verdieranatole-hub/V-plotter-sur-table-a-dessin/README.md

# V-plotter-sur-table-a-dessin
projet de V-plotter réalisé dans le cadre de mon stage de troisième année de licence mécanique au pôle S.mart de l'université polytechnique des Hauts de France.
