verdieranatole-hub/V-plotter-sur-table-a-dessin/liste du materiel.md

# liste du matériel

|produit|quantité nécéssaire|marchand suggéré|prix|
|-|-|-|-|
|arduino uno|2|||
|CNC shield V3|1|||
|A4988 stepper motor driver|2|||
|moteur nema17(modèle prévu: 17HS4023)|2|||
|servomoteur SM2309S (modèle modifiable en fonction de ce dont vous disposez)|1|||
|alimentation S120-12|1|||
|poulie GT2 6mm|2|||
|courroie GT2 6mm|5m|||
|bague bronze ...|1|||
|tasseau (matériau quelconque)|en fonction de la largeur souhaitez de la machine||
|câble 3 fils souple|2,5m|||
|câble avec prise secteur|1 de la longueur que vous souhaitez|||
|ressort 30mm - 13mm - 11mm|1|||
||||estimé: 90€|
