verdieranatole-hub/V-plotter-sur-table-a-dessin/pièces/nacelles/V-plotter-nacelleCorps.step

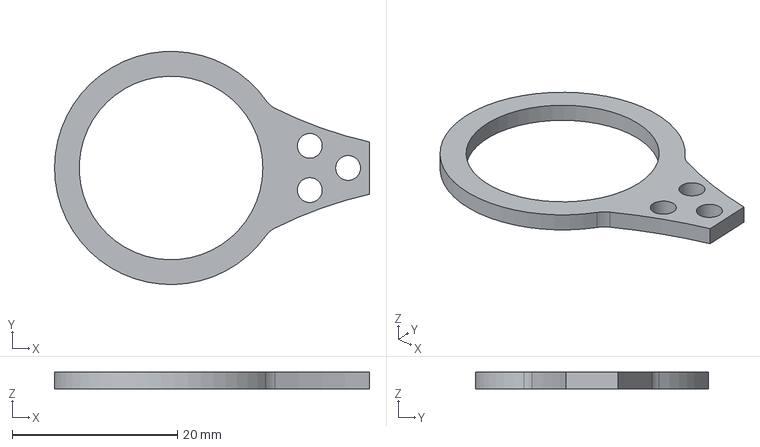
[picture p1: CAD file, 2026-07-15]
pièces/nacelles/V-plotter-nacelleCorps.step
38.1 x 28.2 x 2.00 mm
