verdieranatole-hub/V-plotter-sur-table-a-dessin/pièces/support_moteur.step

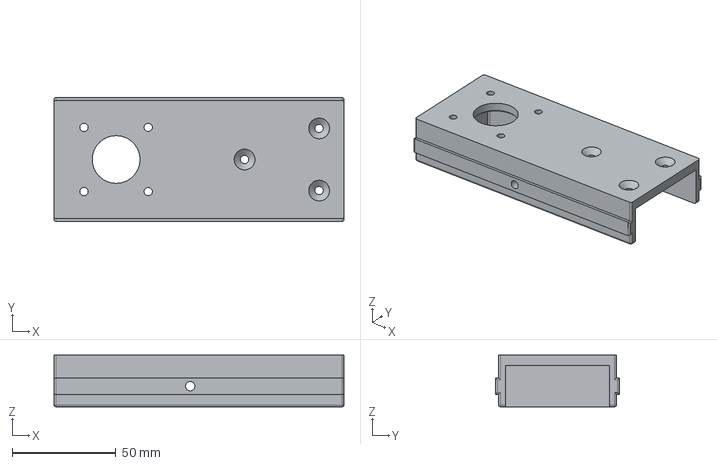
[picture p2: CAD file, 2026-07-13]
pièces/support_moteur.step
140.0 x 60.0 x 25.0 mm
