verdieranatole-hub/V-plotter-sur-table-a-dessin/pièces/nacelles/V-plotter-nacellepatin.step

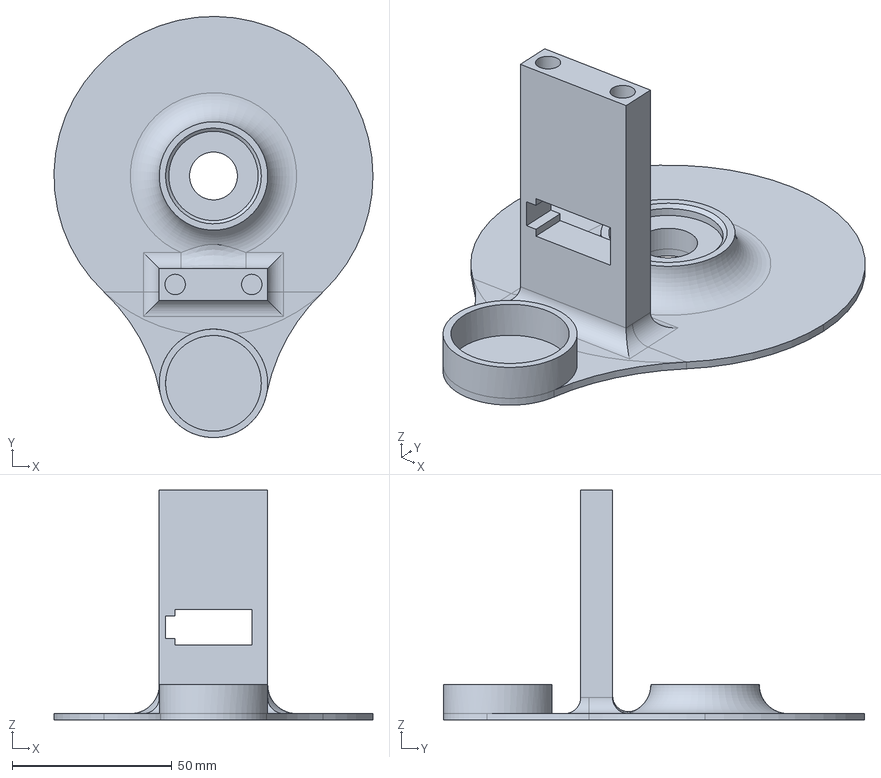
[picture p3: CAD file, 2026-07-15]
pièces/nacelles/V-plotter-nacellepatin.step
100.0 x 132.0 x 72.1 mm
