verdieranatole-hub/V-plotter-sur-table-a-dessin/pièces/V-plotter.FCStd

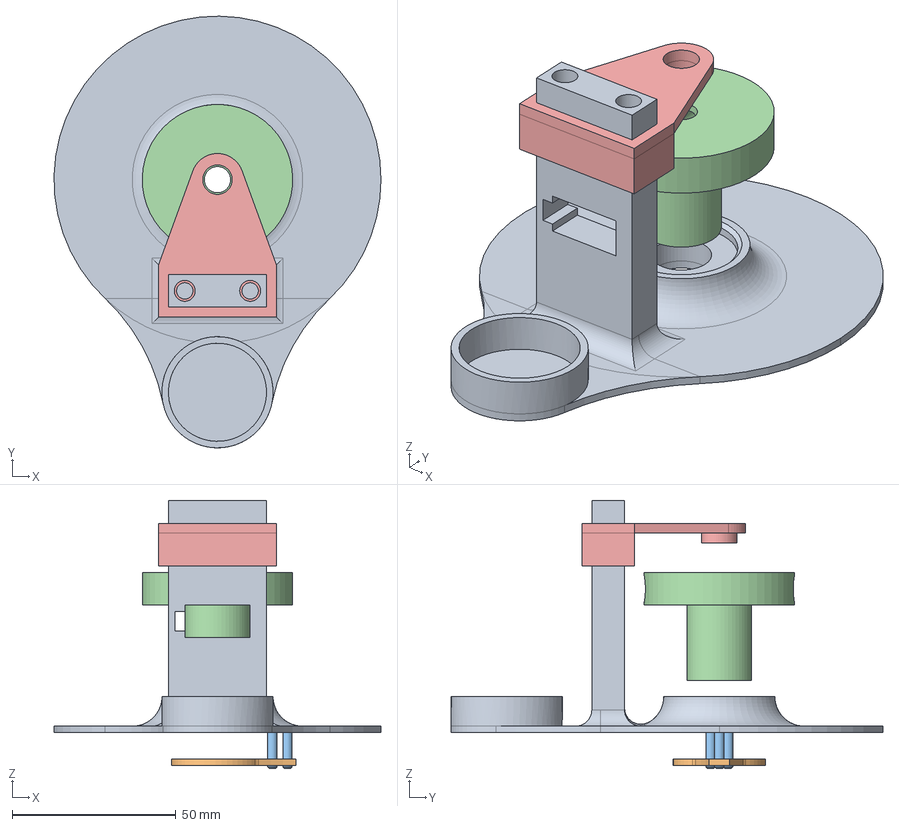
[picture p4: CAD file, 2026-07-13]
pièces/V-plotter.FCStd
100.0 x 132.0 x 82.1 mm
patin
Corps
Corps001
support_crayon
support_ressort
