verdieranatole-hub/V-plotter-sur-table-a-dessin/pièces/nacelles/V-plotter-nacellesupport_courroie_gauche.step

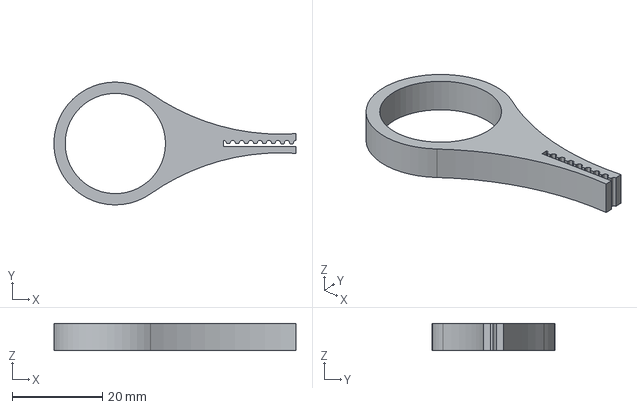
[picture p5: CAD file, 2026-07-15]
pièces/nacelles/V-plotter-nacellesupport_courroie_gauche.step
53.6 x 27.2 x 6.00 mm
