verdieranatole-hub/V-plotter-sur-table-a-dessin/pièces/nacelles/V-plotter-nacellesupport_ressort.step

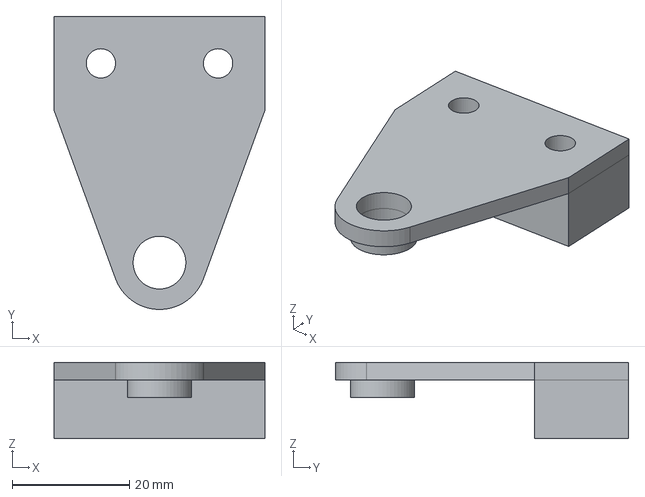
[picture p6: CAD file, 2026-07-15]
pièces/nacelles/V-plotter-nacellesupport_ressort.step
36.0 x 50.0 x 13.0 mm
