verdieranatole-hub/V-plotter-sur-table-a-dessin/pièces/nacelles/V-plotter-nacellesupport_courroie_droite.step

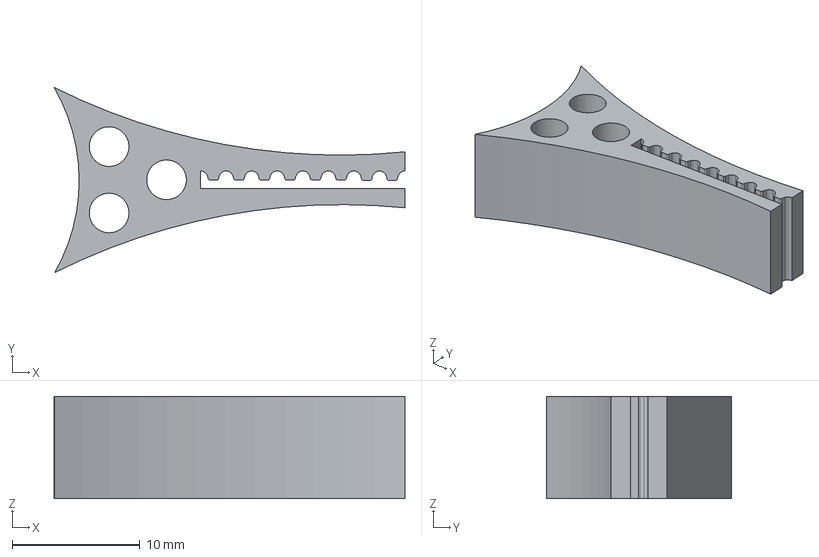
[picture p7: CAD file, 2026-07-15]
pièces/nacelles/V-plotter-nacellesupport_courroie_droite.step
27.5 x 14.5 x 8.00 mm
