verdieranatole-hub/V-plotter-sur-table-a-dessin/pièces/nacelles/V-plotter-nacellesupport_crayon.step

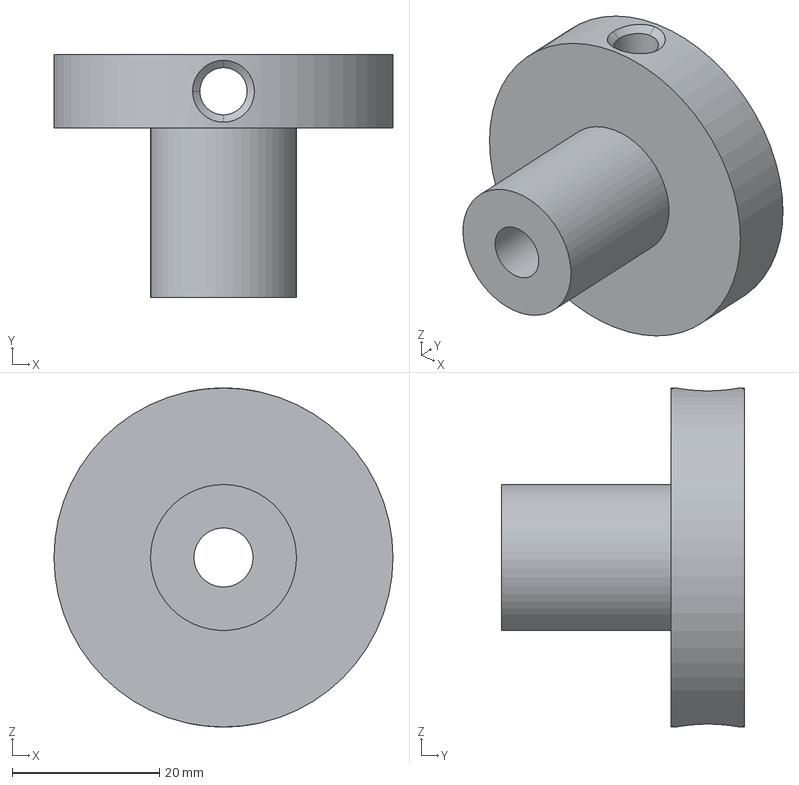
[picture p8: CAD file, 2026-07-15]
pièces/nacelles/V-plotter-nacellesupport_crayon.step
46.0 x 33.0 x 46.0 mm
