verdieranatole-hub/V-plotter-sur-table-a-dessin/pièces/nacelles/V-plotter-nacelleCorps001.step

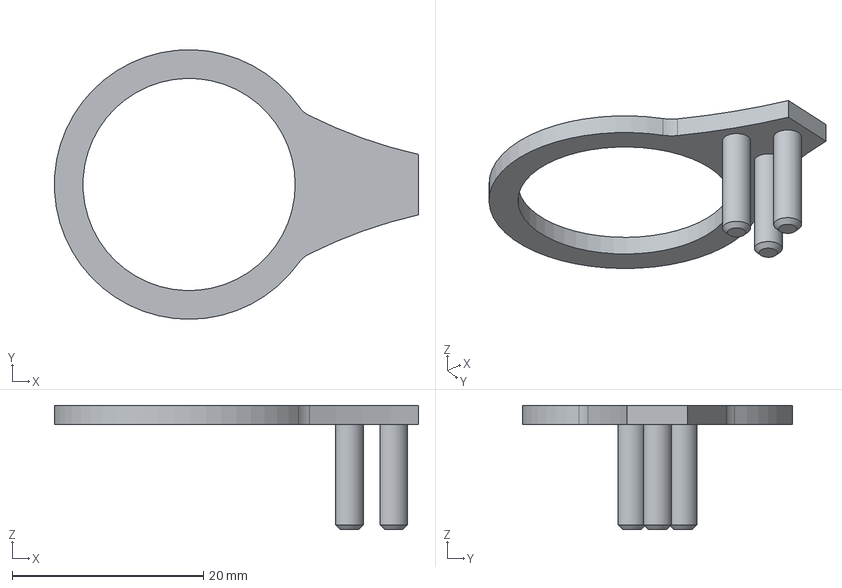
[picture p9: CAD file, 2026-07-15]
pièces/nacelles/V-plotter-nacelleCorps001.step
38.1 x 28.2 x 13.0 mm
