verdieranatole-hub/V-plotter-sur-table-a-dessin/(commit log)

2026-06-30 Rename distance entre les sorties de courroies.png to preprocesseur/images/distance entre les sorties de courroies.png
2026-06-30 Rename longueur d'origine des courroies.png to preprocesseur/images/longueur d'origine des courroies.png
2026-06-30 Rename taille des segments.png to preprocesseur/images/taille des segments.png
2026-06-30 Insert image placeholder in usage guide
    Added an image placeholder in the usage guide.
2026-06-30 Rename taille des segments.png to taille_des_segments.png
2026-06-30 Rename longueur d'origine des courroies.png to longueur_origine_des_courroies.png
2026-06-30 Rename distance entre les sorties de courroies.png to distance_entre_les_sorties_de_courroies.png
2026-06-30 Update usage guide with cable distance section
2026-06-30 Fix image link for initial belt lengths
2026-07-01 Update README.md
    Added a section about 3D printable parts and assembly options.
2026-07-12 Add servo control code in controle_servo.iso
    Implement basic servo control logic using an analog sensor.
2026-07-13 Add files via upload
    Ce fichier permet de généré la nacelle à l'aide de FREECAD au cas où vous auriez des composants différents de ce qui auraient été spécifié dans la liste de matériel.
    [V-plotter.FCStd]
2026-07-13 Add montage.md with assembly instructions
2026-07-13 Add programming instructions for CNC shield V3
    Added information about programming the CNC shield V3 using GRBL.
2026-07-13 Update GRBL source link in montage.md
2026-07-15 Enhance CNC setup instructions in montage.md
    Added detailed instructions for GRBL installation and UGS configuration, including step-by-step parameters for steps per revolution, maximum speed, and acceleration settings.
2026-07-15 Update spring description in material list
2026-07-15 Enhance assembly instructions for V-plotter
    Added detailed steps for assembling the V-plotter, including mounting instructions for the rule, motors, and electronic housing.
2026-07-15 Mise à jour des instructions de montage du V-plotter
    Ajout de plusieurs étapes détaillées pour le montage et la programmation du V-plotter, y compris des instructions spécifiques pour l'assemblage des composants et le câblage.
2026-07-16 Revise V-plotter assembly and wiring instructions
    Updated assembly instructions for the V-plotter, including detailed steps for mounting the gimbal, wiring the electronics, and programming the Arduino boards.
2026-07-16 Revise zero marking instructions for clarity
    Clarified the instructions for zero marking and belt length measurement, improving precision details.
2026-07-16 Mise à jour du guide d'utilisation du préprocesseur
    Ajout d'une section sur le nettoyage du Gcode et suppression de l'introduction.
2026-07-16 Ajouter des précisions sur la mesure de la courroie
    Ajout d'une remarque sur la mesure de la courroie pour plus de précision.
2026-07-16 Rename stage L3 (1).odt to cinematique.odt
